mkreider/dc-motor-hw/Pflichtenheft, Bauteilliste, Bestelliste/Bauteilliste.xls

Bauteilliste
Menge | Bauteil | Wert
7 | C1,C3,C9-C11, C13,C14 | 100nF
3 | C2,C7,C8 | 20nF
2 | C4,C6 | 100µF
1 | C5 | 47µF
1 | C12 | 0,22µF
2 | C15,C16 | 15pF
1 | D1 | 1N4007
1 | D2 | 1,5KB33CA
1 | F1 | F 2A
1 | F2 | T 0,5A
1 | G1 | 8MHz
1 | IC1 | AT MEGA32-A
1 | R1 | DC-DC Wandler
1 | R2 | 0,05R /2W
8 | R3,R8-R10,R13,R33-R35 | 2,7kΩ
4 | R4,R6,R11,R38 | 39kΩ
4 | R5,R7,R12,R39 | 10kΩ
2 | R14,R15 | 3,3kΩ
5 | R16-R19,R27 | 330Ω
4 | R20-R23 | 270Ω
5 | R24,R28,R31,R32,R37 | 100kΩ
5 | R25,R26,R29,R30, R36 | 10Ω
2 | S2,S3 | Drucktaster
1 | X1 | Female subd
1 | X2 | male subd
1 | U$17 | MAX4080 Motortreiber
1 | U$3 | DRV8800
2 | U$28,U$34 | Transistor
3 | U$35,U$38,U$50 | MosFet
