mkreider/dc-motor-hw/Pflichtenheft, Bauteilliste, Bestelliste/Bestell_Bauteilliste.xls

Pos. | Menge | ME | CAD-ID | Bauteil Bezeichnung | Wert/Typ | Bemerkungen | Bestellnummer Lieferant/ Hersteller | Lieferant | Hersteller | Preis/St. | Preis/Ges.
1 | 7 |  |  | SMD-Vielschicht-Kondensator | 100nF | DC-Motorsteuerung | X7R-G0805 100N | Reichelt | Yaego | 0.05 | 0.35 €
2 | 3 |  |  | SMD-Vielschicht-Kondensator | 10nF | DC-Motorsteuerung | X7R-G0805 10N | Reichelt | Yaego | 0.05 | 0.15 €
3 | 2 |  |  | Elektrolyt-Kondensatoren | 100µF/50V | DC-Motorsteuerung | 1129 | GSI | Panasonic |  | 0.00 €
4 | 1 |  |  | Elektrolyt-Kondensatoren | 47µ/100V | DC-Motorsteuerung | 1141 | GSI | Panasonic |  | 0.00 €
5 | 1 |  |  | SMD-Vielschicht-Kondensator | 0,22µF 16V | DC-Motorsteuerung | 445222-62 | conrad | Kerko_Chio | 0.08 | 0.08 €
6 | 2 |  |  | SMD-Vielschicht Kondensator | 15pF | DC-Motorsteuerung | 460052-62 | conrad | Philips | 0.06 | 0.12 €
7 | 1 |  |  | Gleichrichter Diode | 1000V /1A | DC-Motorsteuerung | 1278 | GSI | Fairchild |  | 0.00 €
8 | 1 |  |  | Überspannungschutz Diode | 33V / 600W | DC-Motorsteuerung | P6KE 33CA | Reichelt | ST | 0.16 | 0.16 €
9 | 1 |  |  | Sicherung | 250V /2A Flink | DC-Motorsteuerung | 2558 | GSI | Wickmann |  | 0.00 €
10 | 1 |  |  | Sicherung | 250V / 0,5A Träge | DC-Motorsteuerung | 2581 | GSI | Wickmann |  | 0.00 €
11 | 1 |  |  | DC-DC Wandler | 5V/ 0.5 A | DC-Motorsteuerung | 154483-62 | Conrad | Recom International | 7.57 | 7.57 €
12 | 8 |  |  | Widerstände | 2,7k | DC-Motorsteuerung | SMD-0805 2,70K | Reichelt |  | 0.10 | 0.82 €
13 | 4 |  |  | Widerstände | 39k | DC-Motorsteuerung | SMD-0805 39,0K | Reichelt |  | 0.10 | 0.41 €
14 | 4 |  |  | Widerstände | 10k | DC-Motorsteuerung | SMD-0805 10,0K | Reichelt |  | 0.10 | 0.41 €
15 | 2 |  |  | Widerstände | 3,3 k | DC-Motorsteuerung | SMD-0805 3,30K | Reichelt |  | 0.10 | 0.21 €
16 | 5 |  |  | Widerstände | 330 Ohm | DC-Motorsteuerung | SMD-0805 330 | Reichelt |  | 0.10 | 0.52 €
17 | 4 |  |  | Widerstände | 250 Ohm | DC-Motorsteuerung | SMD-0805 270 | Reichelt |  | 0.10 | 0.41 €
18 | 5 |  |  | Widerstände | 100k | DC-Motorsteuerung | SMD-0805 100k | Reichelt |  | 0.10 | 0.52 €
19 | 5 |  |  | Widerstände | 10 Ohm | DC-Motorsteuerung | SMD-0805 10,0 | Reichelt |  | 0.10 | 0.52 €
20 | 2 |  |  | Motor Treiber |  | DC-Motorsteuerung | 595-DRV8800RTYT | Mouser | Texas Instruments | 2.75 | 5.50 €
21 | 2 |  |  | Stromrichtungsverstärker |  | DC-Motorsteuerung | 700-MAX4080TASA | Mouser | Maxim Integrated Products | 2.23 | 4.46 €
22 | 2 |  |  | Transistor-Ausgangskoppler |  | DC-Motorsteuerung | 630-ACPL-247-500E | Mouser | Avago Technologies | 1.66 | 3.32 €
23 | 3 |  |  | MOSFET |  | DC-Motorsteuerung | 942-IRF7341TRPBF | Mouser | International Rectifier | 1.05 | 6.30 €
24 | 2 |  |  | Sicherungshalter |  | DC-Motorsteuerung | 529667-62 | Conrad | Bulgin | 2.55 | 5.10 €
25 | 3 |  |  | Taster |  | DC-Motorsteuerung | 183535-62 | Conrad | Mentor | 2.15 | 6.45 €
26 | 1 |  |  | Kourzhubtaster |  | DC-Motorsteuerung | 700324-62 | Conrad | Apem | 0.22 | 0.22 €
27 | 1 |  |  | 8MHz Quarz |  | DC-Motorsteuerung | 156453-62 | Conrad | EuroQuarz | 0.54 | 0.54 €
28 | 1 |  |  | Schalter |  | DC-Motorsteuerung | 611-7101SHAGE | Mouser |  | 5.68 | 5.68 €
29 | 4 |  |  | LED |  | DC-Motorsteuerung | 1714(GN),1712(RT) | GSI |  |  | 0.00 €
30 | 1 |  |  | RGB LED |  | DC-Motorsteuerung | 41251 | pur-led | pur-led | 1.39 | 1.39 €
31 | 1 |  |  | Frontplatte |  | DC-Motorsteuerung |  |  |  |  | 16.00 €
32 | 1 |  |  | Platine Extern |  | DC-Motorsteuerung |  |  |  |  | 6.00 €
33 | 1 |  |  | Messwiderstand |  | DC-Motorsteuerung | 443765-62 | Conrad | NOVA Elektronik GmbH | 0.95 | 0.95 €
34 | 1 |  |  | AT-MEGA 32A |  | DC-Motorsteuerung | 157687-62 | Conrad | ATMEL | 5.16 | 5.16 €
 |  |  |  |  |  |  |  |  |  |  | 78.81 €
