mkreider/dc-motor-hw/(list of files, cad)

Other CAD files:
Frontplatte/Grundsätzliches/0.17 Frontgriff_Abdeckung.ipt
Frontplatte/Grundsätzliches/0.1_Lagerbuchse.ipt
Frontplatte/Grundsätzliches/0.2_Frontgriff.ipt
Frontplatte/Grundsätzliches/0.3_Leiterplattenhalter_Links.ipt
Frontplatte/Grundsätzliches/0.4_Leiterplattenhalter_Rechts.ipt
Frontplatte/Grundsätzliches/0.5_Lochrasterplatine.ipt
Frontplatte/Grundsätzliches/FrontplatteFG698.ipt
Frontplatte/Grundsätzliches/HLSHR-25-123-ST-VN.ipt
Frontplatte/Grundsätzliches/LED´s.ipt
Frontplatte/Grundsätzliches/NIPPEL-------KU---.ipt
Frontplatte/Grundsätzliches/OldVersions/Sicherungshalter.0008.ipt
Frontplatte/Grundsätzliches/Schalter.ipt
Frontplatte/Grundsätzliches/SicherungshalterVersion2.ipt
Frontplatte/Grundsätzliches/Taster.ipt
Frontplatte/Version1.iam
