mkreider/dc-motor-hw/dc-motor.brd

## EAGLE design dc-motor.brd (2013-01-18)

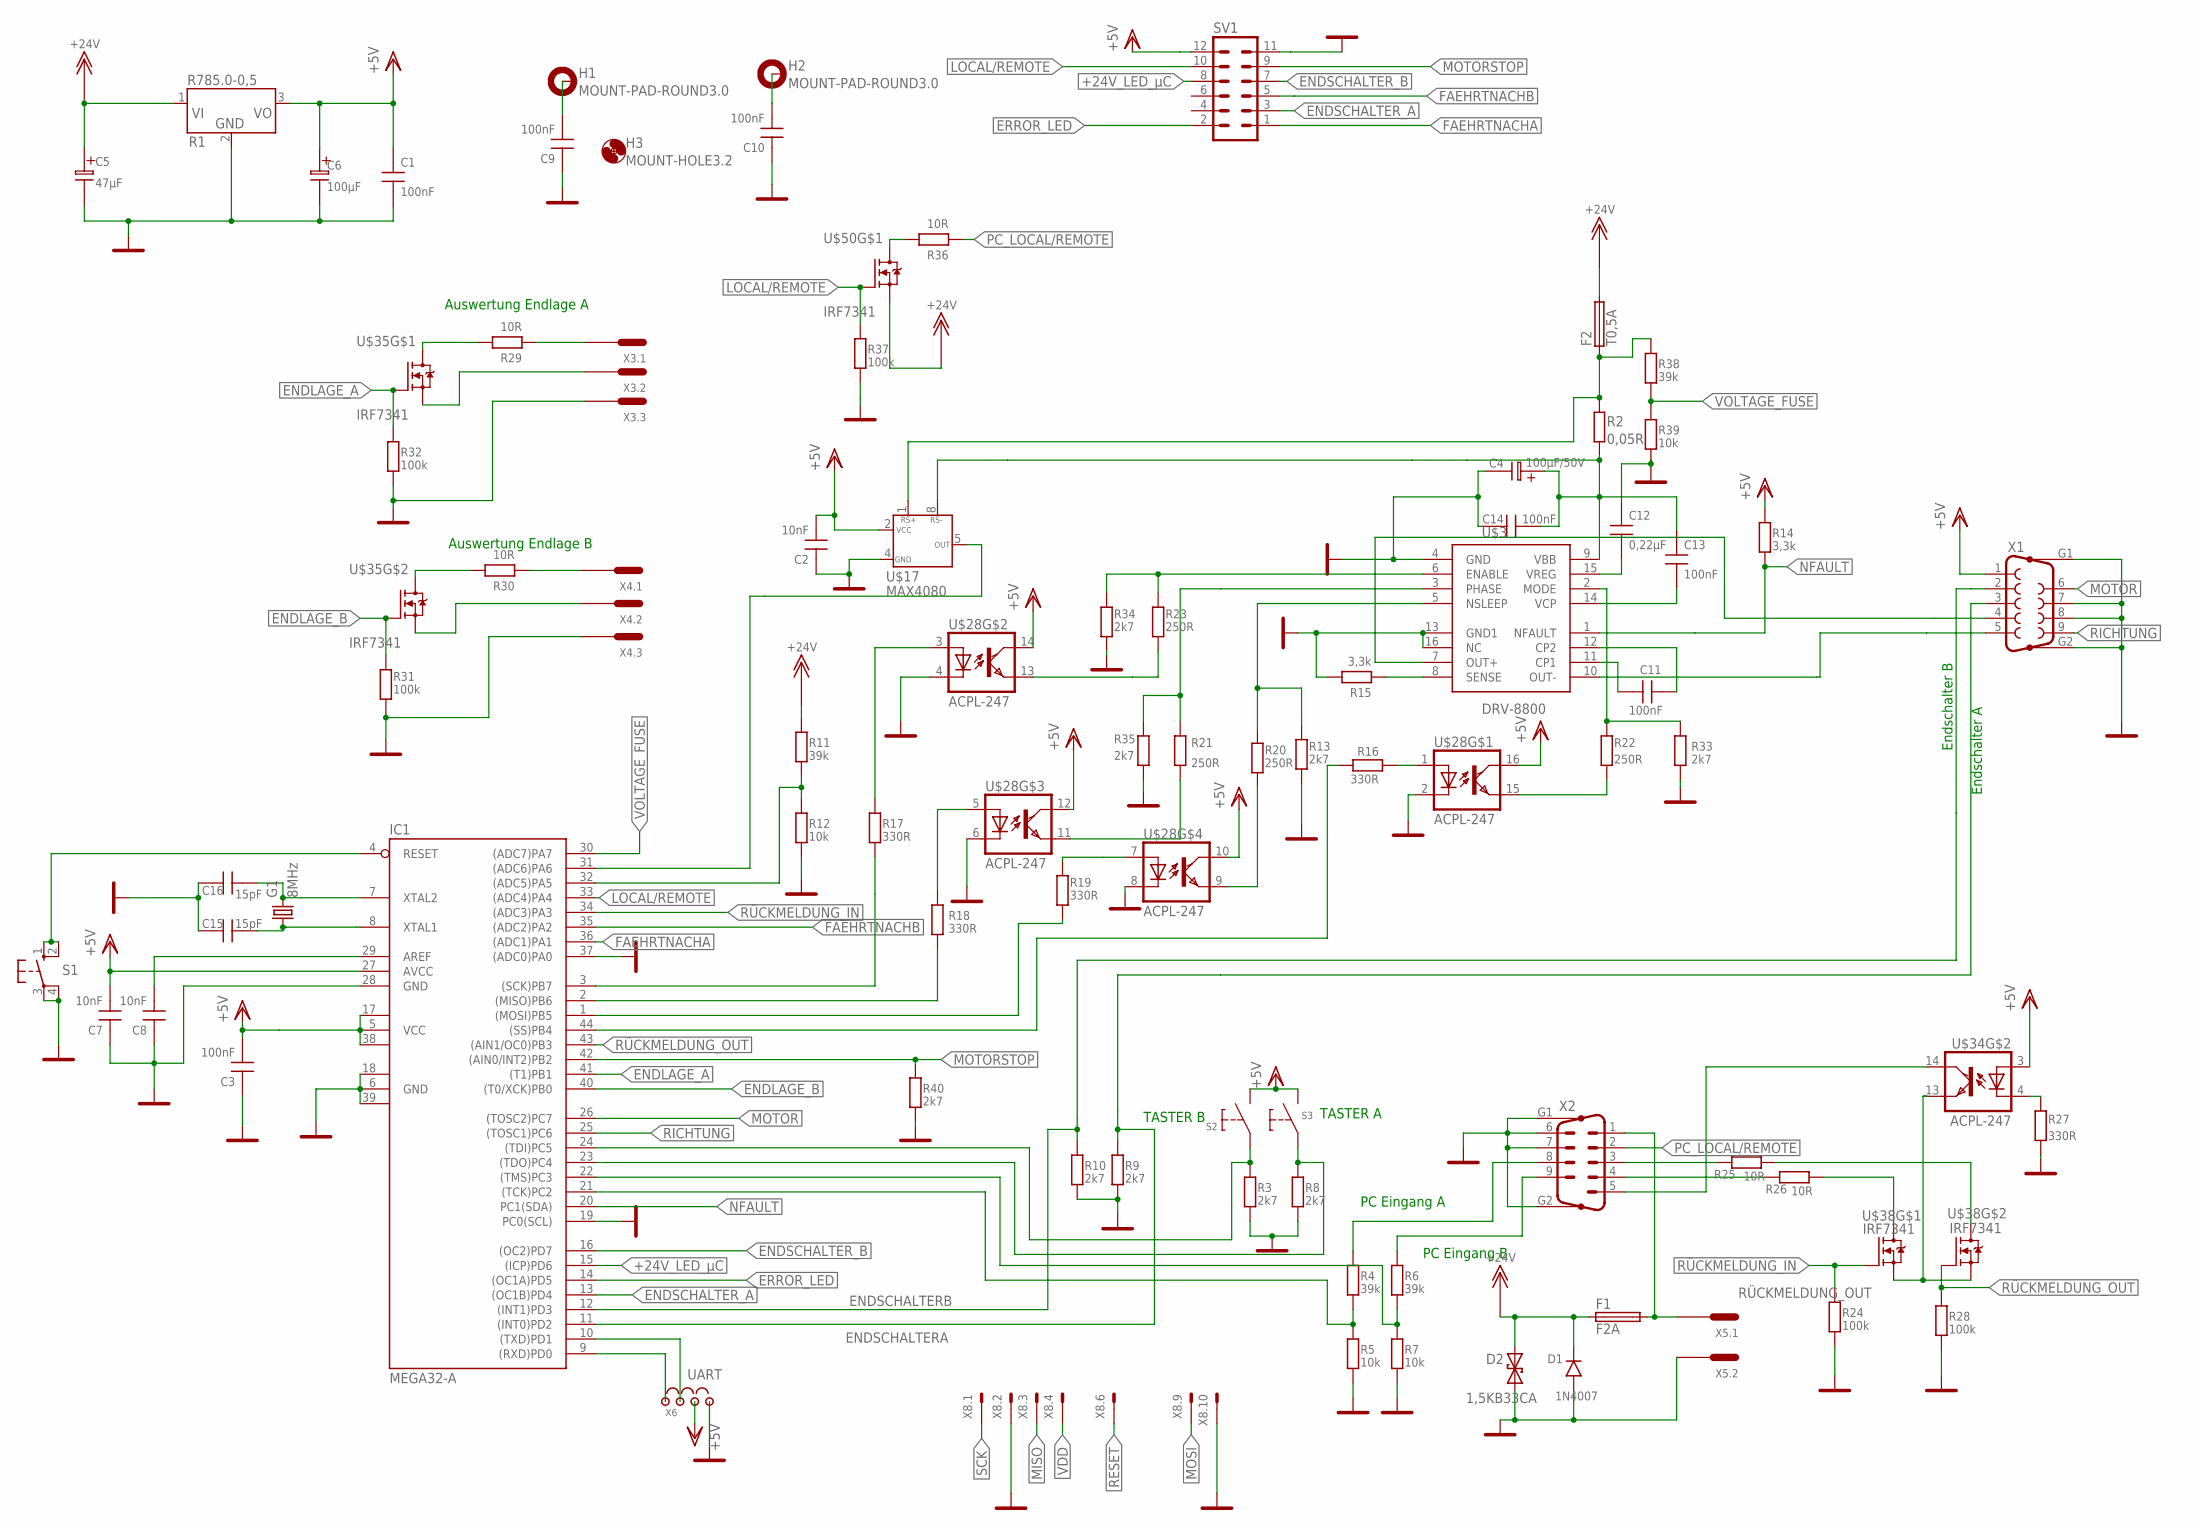
[picture p1: schematic dc-motor.sch]

Parts:
C1, C3, C9, C10, C11, C13, C14: 100nF; 0805
C2, C7, C8: 10nF; 0805
C4: 100µF/50V; E5-13
C5: 47µF; E5-13
C6: 100µF; E5-13
C12: 0,22µF; 0805
C15, C16: 15pF; 0805
D1: 1N4007; RM10DR1
D2: 1,5KB33CA; CB417-15
F1: F2A; F457
F2: T0,5A; F457
G1: 8MHz; HC18U-V
H1, H2: MOUNT-PAD-ROUND3.0; 3,0-PAD
H3: MOUNT-HOLE3.2; 3,2
IC1: MEGA32-A; TQFP44; MPN ATMEGA32-16AU
R1: R785.0-0,5; SIP3
R2: 0,05R; SMS-0
R3, R8, R9, R10, R13, R33, R34, R35, R40: 2k7; 0805
R4, R6, R11, R38: 39k; 0805
R5, R7, R12, R39: 10k; 0805
R14, R15: 3,3k; 0805
R16, R17, R18, R19, R27: 330R; 0805
R20, R21, R22, R23: 250R; 0805
R24, R28, R31, R32, R37: 100k; 0805
R25, R26, R29, R30, R36: 10R; 0805
S1: 10-XX; B3F-10XX
S2, S3: DRUCKTASTER_ABGW; 1_POL_ABGW
SV1: MA06-2
U$3: DRV-8800; TSSOP16
U$17: MAX4080
U$28, U$34: ACPL-247; SOIC16
U$35, U$38, U$50: IRF7341; SO08-IRF
X1: F09HP
X2: M09HP
X3, X4: RIA_3POL
X5: RIA_2POL
X6: JUMP1-4
X8: PFVERB10

Connections:
+24V: C5.+, D1.K, D2.C (2), F1.1, F2.2, R1.1, R11.2, U$50.1 (N-S1)
+24V_LED_µC: IC1.15 ((ICP)PD6), SV1.8
ENDLAGE_A: IC1.41 ((T1)PB1), R32.1, U$35.2 (N-G1)
ENDLAGE_B: IC1.40 ((T0/XCK)PB0), R31.1, U$35.4 (N-G1)
ENDSCHALTERA: IC1.11 ((INT0)PD2), R9.2, X1.3
ENDSCHALTERB: IC1.12 ((INT1)PD3), R10.2, X1.2
ENDSCHALTER_A: IC1.13 ((OC1B)PD4), SV1.3
ENDSCHALTER_B: IC1.16 ((OC2)PD7), SV1.7
ERROR_LED: IC1.14 ((OC1A)PD5), SV1.2
FAEHRTNACHA: IC1.36 ((ADC1)PA1), SV1.1
FAEHRTNACHB: IC1.35 ((ADC2)PA2), SV1.5
GND: C1.1, C2.1, C3.1, C4.-, C5.-, C6.-, C7.1, C8.1, C9.1, C10.1, C12.1, C14.1, C15.2, C16.2, D1.A, D2.A (1), IC1.6 (GND), IC1.18 (GND1), IC1.19 (PC0(SCL)), IC1.28 (GND), IC1.37 ((ADC0)PA0), IC1.39 (GND2), R1.2, R3.1, R5.1, R7.1, R8.1, R9.1, R10.1, R12.1, R13.1, R15.2, R24.2, R27.1, R28.2, R31.2, R32.2, R33.1, R34.1, R35.1, R37.2, R39.1, R40.1, S1.3, S1.4 (P1), SV1.11, U$3.4 (GND), U$3.13 (GND1), U$3.16 (NC), U$17.4 (GND), U$28.2 (C), U$28.4 (C), U$28.6 (C), U$28.8 (C), X1.7, X1.8, X1.G1, X1.G2, X2.6, X2.7, X2.G1, X2.G2, X3.P$3, X4.P$3, X5.P$2, X6.4, X8.2, X8.10
LOCAL/REMOTE: IC1.33 ((ADC4)PA4), R37.1, SV1.10, U$50.2 (N-G1)
MISO: IC1.2 ((MISO)PB6), R18.2, X8.3
MOSI: IC1.1 ((MOSI)PB5), R19.1, X8.9
MOTOR: IC1.26 ((TOSC2)PC7), X1.6
MOTORSTOP: IC1.42 ((AIN0/INT2)PB2), R40.2, SV1.9
unnamed: F1.2, X2.1, X5.P$1
unnamed: C15.1, G1.1, IC1.8 (XTAL1)
unnamed: C16.1, G1.2, IC1.7 (XTAL2)
unnamed: IC1.9 ((RXD)PD0), X6.1
unnamed: F2.1, R2.1, R38.2, U$17.1 (RS+)
unnamed: R18.1, U$28.5 (A)
unnamed: IC1.10 ((TXD)PD1), X6.2
unnamed: IC1.21 ((TCK)PC2), R4.1, R5.2
unnamed: IC1.31 ((ADC6)PA6), U$17.5 (OUT)
unnamed: IC1.22 ((TMS)PC3), R6.1, R7.2
unnamed: R6.2, X2.9
unnamed: R4.2, X2.8
unnamed: R20.2, U$28.9 (EMIT)
unnamed: IC1.23 ((TDO)PC4), R8.2, S3.S1 (C)
unnamed: IC1.24 ((TDI)PC5), R3.2, S2.S1 (C)
unnamed: R19.2, U$28.7 (A)
unnamed: IC1.32 ((ADC5)PA5), R11.1, R12.2
unnamed: C9.2, H1.B3,0
unnamed: C10.2, H2.B3,0
unnamed: C11.2, U$3.11 (CP1)
unnamed: C11.1, U$3.12 (CP2)
unnamed: C12.2, U$3.15 (VREG)
unnamed: C13.2, U$3.14 (VCP)
unnamed: R23.1, R34.2, U$3.6 (ENABLE)
unnamed: C4.+, C13.1, C14.2, R2.2, U$3.9 (VBB), U$17.8 (RS-)
unnamed: R13.2, R20.1, U$3.5 (NSLEEP)
unnamed: R22.2, U$28.15 (EMIT)
unnamed: R15.1, U$3.8 (SENSE)
unnamed: U$34.14 (COL), X2.5
unnamed: IC1.44 ((SS)PB4), R16.1
unnamed: R36.2, U$50.7 (D1), U$50.8 (D1)
unnamed: R21.1, R35.2, U$3.3 (PHASE)
unnamed: U$3.7 (OUT+), X1.4
unnamed: R16.2, U$28.1 (A)
unnamed: R17.1, U$28.3 (A)
unnamed: U$3.10 (OUT-), X1.5
unnamed: R23.2, U$28.13 (EMIT)
unnamed: R21.2, U$28.11 (EMIT)
unnamed: R22.1, R33.2, U$3.2 (MODE)
unnamed: R26.2, X2.4
unnamed: R25.2, X2.3
unnamed: U$34.13 (EMIT), U$38.1 (N-S1), U$38.3 (N-S1)
unnamed: R25.1, U$38.5 (D1), U$38.6 (D1)
unnamed: C8.2, IC1.29 (AREF)
unnamed: R27.2, U$34.4 (C)
unnamed: R26.1, U$38.7 (D1), U$38.8 (D1)
unnamed: R29.1, X3.P$1
unnamed: R30.1, X4.P$1
unnamed: R30.2, U$35.5 (D1), U$35.6 (D1)
unnamed: U$35.3 (N-S1), X4.P$2
unnamed: R29.2, U$35.7 (D1), U$35.8 (D1)
unnamed: U$35.1 (N-S1), X3.P$2
NFAULT: IC1.20 (PC1(SDA)), R14.1, U$3.1 (NFAULT)
PC_LOCAL/REMOTE: R36.1, X2.2
RESET: IC1.4 (RESET), S1.1 (S), S1.2 (S1), X8.6
RICHTUNG: IC1.25 ((TOSC1)PC6), X1.9
RÜCKMELDUNG_IN: IC1.34 ((ADC3)PA3), R24.1, U$38.2 (N-G1)
RÜCKMELDUNG_OUT: IC1.43 ((AIN1/OC0)PB3), R28.1, U$38.4 (N-G1)
SCK: IC1.3 ((SCK)PB7), R17.2, X8.1
VDD: C1.2, C2.2, C3.2, C6.+, C7.2, IC1.5 (VCC), IC1.17 (VCC1), IC1.27 (AVCC), IC1.38 (VCC2), R1.3, R14.2, S2.S2 (N0), S3.S2 (N0), SV1.12, U$17.2 (VCC), U$28.10 (COL), U$28.12 (COL), U$28.14 (COL), U$28.16 (COL), U$34.3 (A), X1.1, X6.3, X8.4
VOLTAGE_FUSE: IC1.30 ((ADC7)PA7), R38.1, R39.2

Notes on the sheet:
UART
PC Eingang A
PC Eingang B
TASTER A
TASTER B
Endschalter B
Endschalter A
Auswertung Endlage A
Auswertung Endlage B

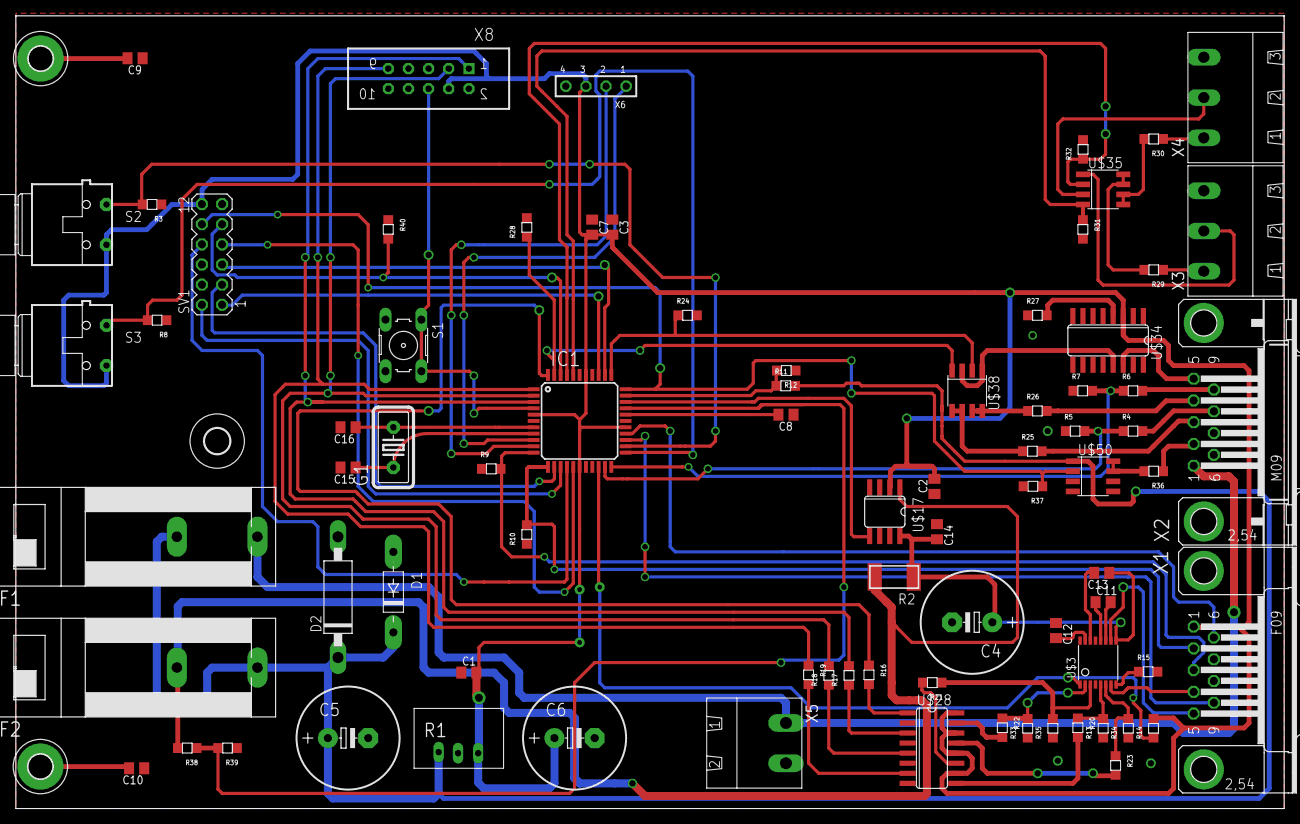
[picture p2: board dc-motor.brd from above]

Board: 2 copper layers, 160.0 x 100.0 mm, 83 parts (0 on the bottom side), 78 nets.
