mkreider/dc-motor-hw/DC_Motorsteuerung_Piggyboard.brd

## EAGLE design DC_Motorsteuerung_Piggyboard.brd (2013-01-14)

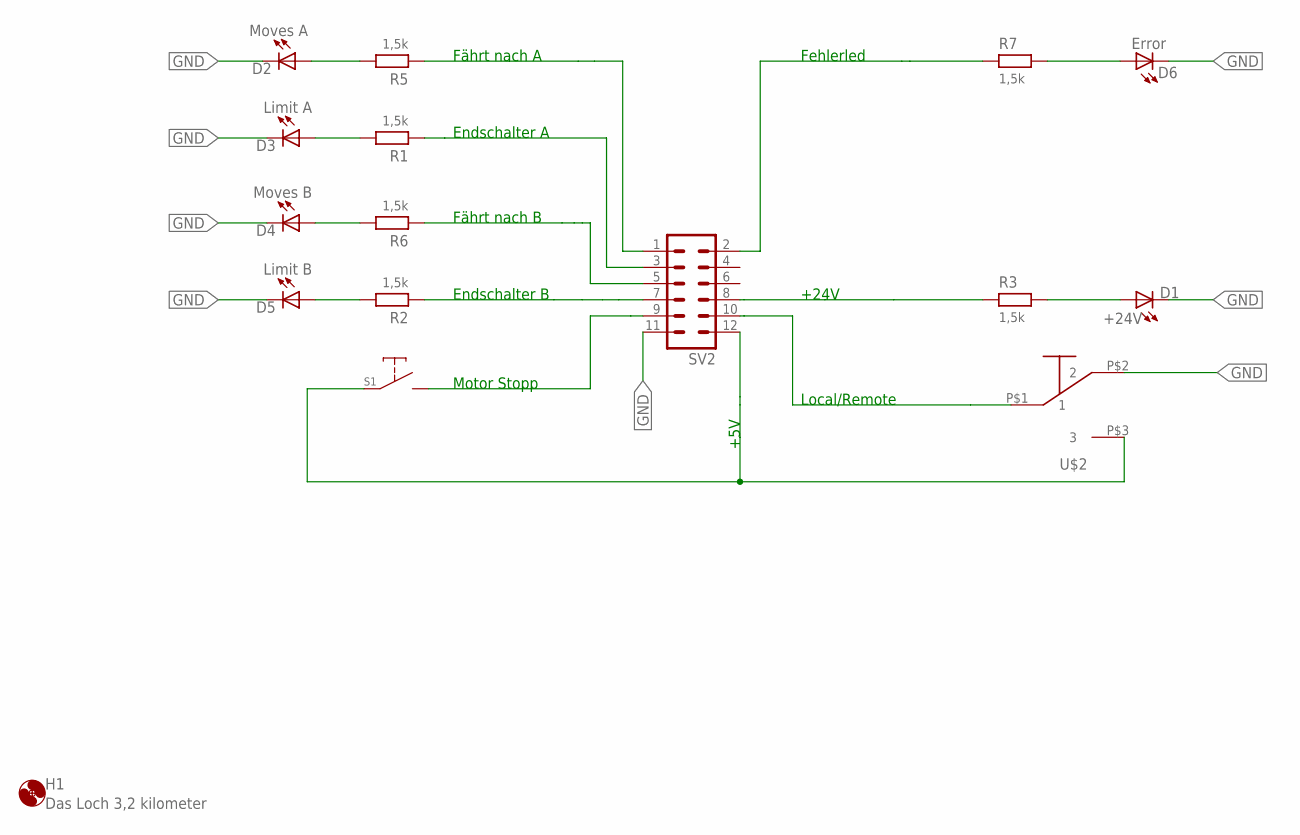
[picture p3: schematic DC_Motorsteuerung_Piggyboard.sch]

Parts:
D1: +24V; LED3MMCASE
D2: Moves A; LED3MMCASE
D3: Limit A; LED3MMCASE
D4: Moves B; LED3MMCASE
D5: Limit B; LED3MMCASE
D6: Error; LED3MMCASE
H1: Das Loch 3,2 kilometer; 3,2
R1, R2, R3, R5, R6, R7: 1,5k; R_0,4W
S1: MotorStopp; 1_POL_ABGW
SV2: MA06-2
U$2: UMSCHALTER_SINGLE_POLE

Connections:
GND: D1.P$2 (C), D2.P$2 (C), D3.P$2 (C), D4.P$2 (C), D5.P$2 (C), D6.P$2 (C), SV2.11, U$2.P$2 (2)
unnamed: R2.1, SV2.7
unnamed: D3.P$1 (A), R1.2
unnamed: R1.1, SV2.3
unnamed: D5.P$1 (A), R2.2
unnamed: D6.P$1 (A), R7.2
unnamed: R3.1, SV2.8
unnamed: S1.S2 (N0), SV2.9
unnamed: SV2.10, U$2.P$1 (1)
unnamed: D4.P$1 (A), R6.2
unnamed: S1.S1 (C), SV2.12, U$2.P$3 (3)
unnamed: R5.1, SV2.1
unnamed: D1.P$1 (A), R3.2
unnamed: D2.P$1 (A), R5.2
unnamed: R7.1, SV2.2
unnamed: R6.1, SV2.5

Notes on the sheet:
Motor Stopp
Local/Remote
Fährt nach A
Fährt nach B
+24V
Endschalter A
Endschalter B
+5V
Fehlerled

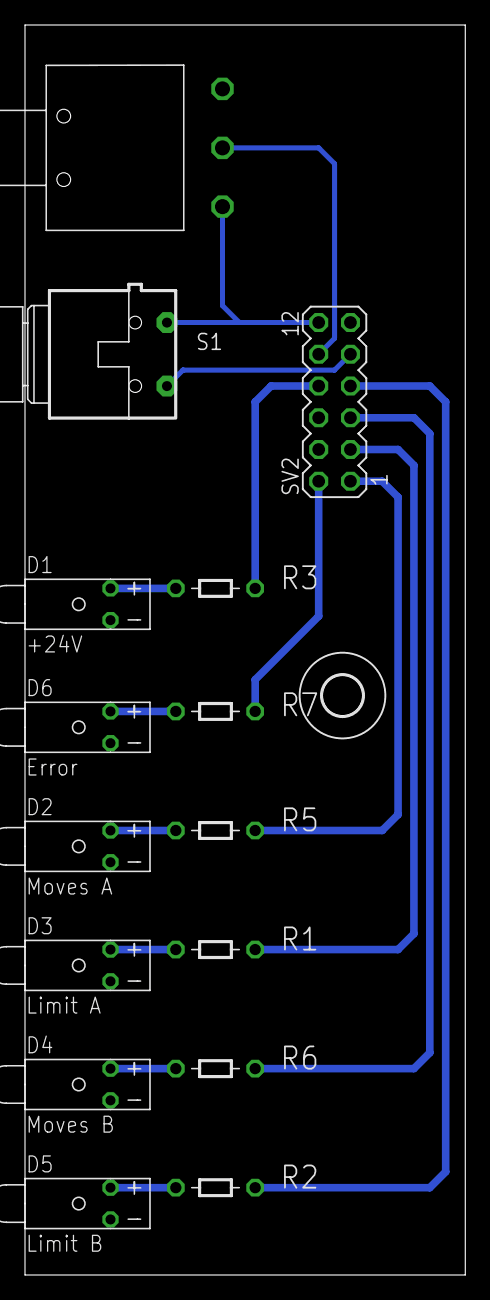
[picture p4: board DC_Motorsteuerung_Piggyboard.brd from above]

Board: 2 copper layers, 35.2 x 100.0 mm, 16 parts (0 on the bottom side), 16 nets.
