mkreider/dc-motor-hw/(commit log)

2012-11-12 created eagle project
    [dc-motor.brd, dc-motor.sch]
2012-11-16 Erste Version des Schaltplans (Noch nicht fertig)
    [dc-motor.brd, dc-motor.sch]
2012-11-19 Schaltplan Fertig
    [dc-motor.brd, dc-motor.sch]
2012-11-19 Schaltplan für Piggyboard eingefügt.
    [DC_Motorsteuerung_Piggyboard.sch]
2012-11-19 Schaltplan Verbessert und mit dem Layout begonnen
    [dc-motor.brd, dc-motor.sch]
2012-11-19 Schaltplan fast fertiggestellt.
    Umschalter (Taster s2) fehlt
    [DC_Motorsteuerung_Piggyboard.sch]
2012-11-19 Schaltplan erweitert
    [dc-motor.brd, dc-motor.sch]
2012-11-21 ADC wiring changed.
    [dc-motor.brd, dc-motor.sch]
2012-11-26 Piggyboard updated
    [DC_Motorsteuerung_Piggyboard.sch]
2012-11-27 Layout finished
    [dc-motor.brd, dc-motor.sch]
2012-11-28 layout checked
    [dc-motor.brd, dc-motor.sch]
2012-11-30 Layout fixed
    [dc-motor.brd, dc-motor.sch]
2012-11-30 Piggy board updated (inclusion of Toggle switch )
    [DC_Motorsteuerung_Piggyboard.sch]
2012-11-30 Piggyboard incl.
    [DC_Motorsteuerung_Piggyboard.brd]
2012-11-30 Piggyboard finished !!
    [DC_Motorsteuerung_Piggyboard.brd]
2012-11-30 Piggyboard finished!!
    [DC_Motorsteuerung_Piggyboard.brd]
2012-12-05 Piggyboard updated and finished !! (RGB-LED included)
    [DC_Motorsteuerung_Piggyboard.brd, DC_Motorsteuerung_Piggyboard.sch]
2012-12-05 Layout edited
    [dc-motor.brd, dc-motor.sch]
2012-12-07 edited again
    [dc-motor.brd, dc-motor.sch]
2012-12-07 Motorstop edited
    [dc-motor.brd, dc-motor.sch]
2012-12-10 moved D1 for description on front plate
    [DC_Motorsteuerung_Piggyboard.brd]
2012-12-11 Created and added the new front panel.
    [0.17 Frontgriff_Abdeckung.ipt, 0.1_Lagerbuchse.ipt, 0.2_Frontgriff.ipt, 0.3_Leiterplattenhalter_Links.ipt, 0.4_Leiterplattenhalter_Rechts.ipt, 0.5_Lochrasterplatine.ipt, FrontplatteFG698.0071.ipt, FrontplatteFG698.ipt]
2012-12-11 Created and added the Specifications, schedule, order list
    [Bauteilliste.xls, Bestell_Bauteilliste.xls]
2012-12-12 Nothing changed
    [Bauteilliste.xls]
2012-12-12 Switch and RGB-LED
    [Bestell_Bauteilliste.xls]
2012-12-12 DC-DC Converter value added
    [dc-motor.brd, dc-motor.sch]
2012-12-17 RGB_LED killed
    [dc-motor.brd, dc-motor.sch]
2012-12-17 Piggiboard updated (ERROR LED)
    [DC_Motorsteuerung_Piggyboard.brd, DC_Motorsteuerung_Piggyboard.sch]
2012-12-17 Piggiboard updated
    [DC_Motorsteuerung_Piggyboard.brd, DC_Motorsteuerung_Piggyboard.sch]
2012-12-17 Piggyboard & Board updated
    [DC_Motorsteuerung_Piggyboard.brd, DC_Motorsteuerung_Piggyboard.sch, dc-motor.brd, dc-motor.sch]
2012-12-21 Pull Down resistor added
    [dc-motor.brd, dc-motor.sch]
2013-01-16 PWR_LED Connected
    [dc-motor.brd, dc-motor.sch]
2013-01-16 new version
    [FrontplatteFG698.0071.ipt, FrontplatteFG698.ipt, Version1.iam]
2013-01-18 just weired
    [dc-motor.brd, dc-motor.sch]
